uns8t3d/honda_accord7_serial_reader_and_subdisplay/img/schema.png

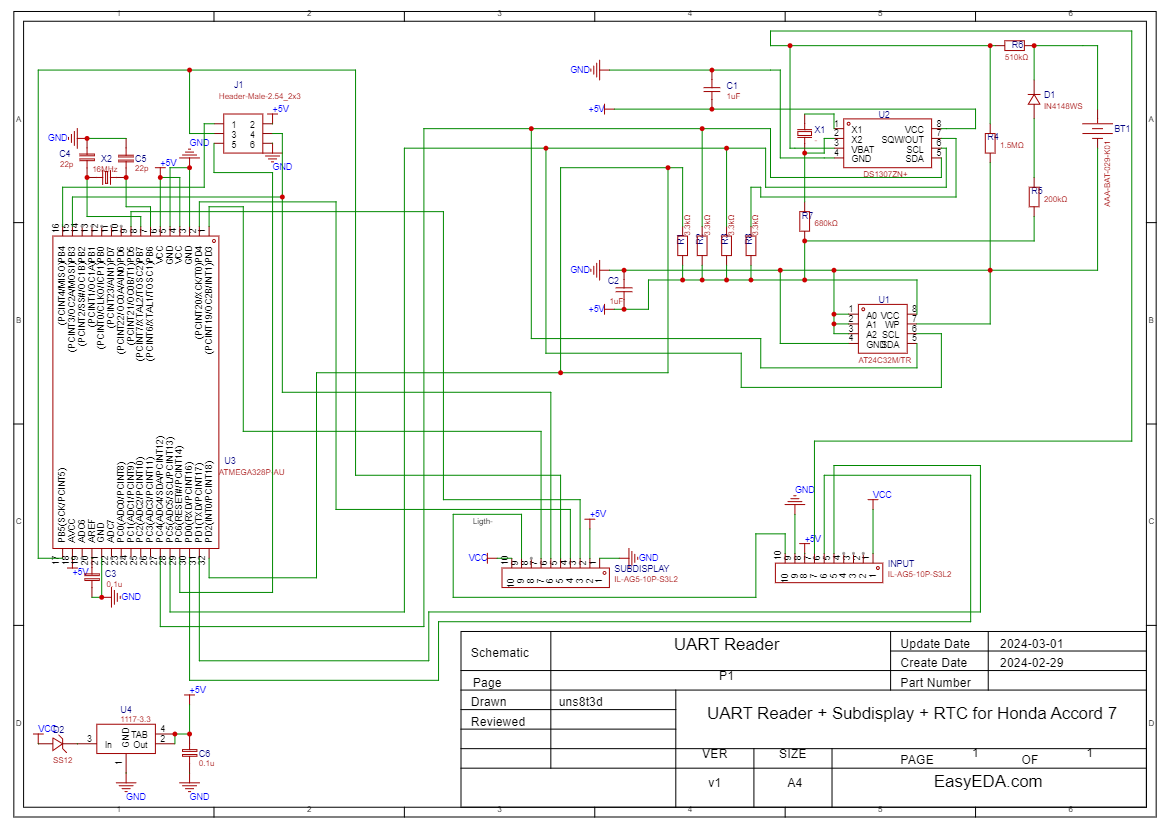
img/schema.png
