uns8t3d/honda_accord7_serial_reader_and_subdisplay/PCB/V2/V2_back.png

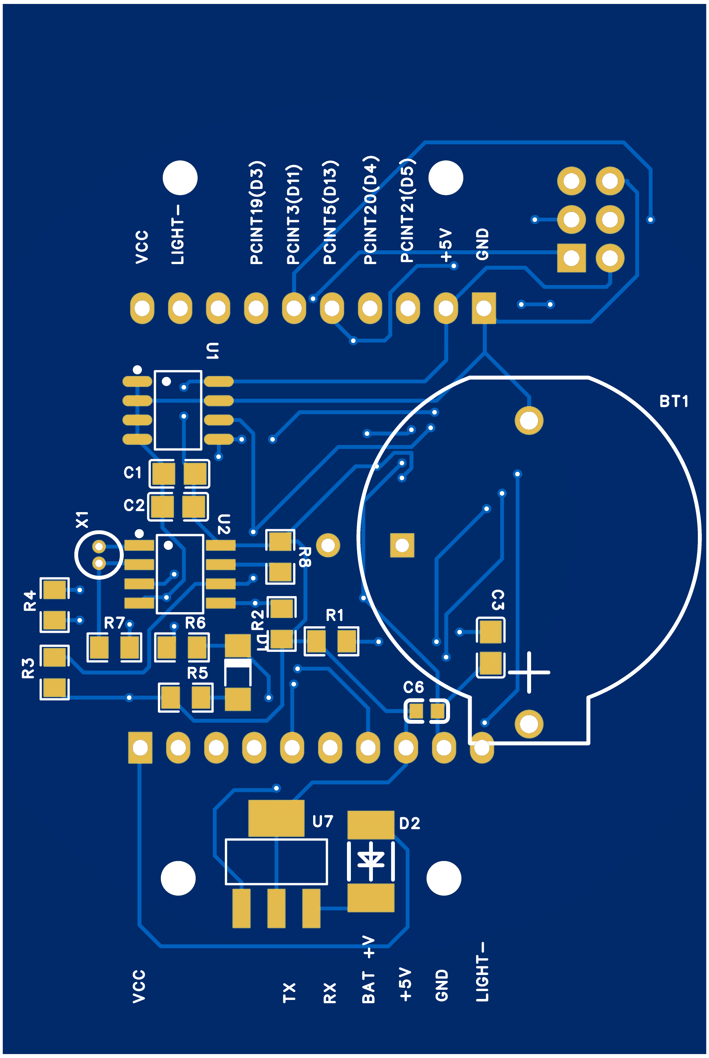
PCB/V2/V2_back.png
