uns8t3d/honda_accord7_serial_reader_and_subdisplay/PCB/V2/SerialReaderAndSubdisplay_V2_BOM.xlsx

No. | Quantity | Comment | Designator | Footprint | Value | Manufacturer Part | Manufacturer | Supplier Part | Supplier | Pins
1 | 1 | AAA-BAT-029-K01 | BT1 | BAT-TH_AAA-BAT-029-K01 |  | AAA-BAT-029-K01 | LOTES(嘉澤端子) | C962133 | LCSC | 2
2 | 2 | 1uF | C1,C2 | C0805 |  |  |  |  |  | 2
3 | 1 | 0.1u | C3 | C0805 |  |  |  |  |  | 2
4 | 2 | 22p | C4,C5 | C0603 |  |  |  |  |  | 2
5 | 1 | 0.1u | C6 | C0603 |  |  |  |  |  | 2
6 | 1 | IN4148WS | D1 | SOD-80_L3.5-W1.5-RD |  | IN4148WS | LRC(乐山无线电) | C417545 | LCSC | 2
7 | 1 | SS12 | D2 | SMA-L_L4.4-W2.6-LS5.0-RD |  | SS12 |  | C379819 | LCSC | 2
8 | 2 | IL-AG5-10P-S3L2 | INPUT,SUBDISPLAY | CONN-TH_10P-P2.50_IL-AG5-10P-S3L2 |  | IL-AG5-10P-S3L2 | JAE(日本航空电子) | C2891425 | LCSC | 10
9 | 1 | Header-Male-2.54_2x3 | J1 | HDR-TH_6P-P2.54-V-M-R2-C3-S2.54-1 |  | Header-Male-2.54_2x3 | BOOMELE | C65114 | LCSC | 6
10 | 4 | 3.3kΩ | R1,R2,R3,R8 | R0805 |  | ERA6VEB4702V | PANASONIC(松下) | C490805 | LCSC | 2
11 | 1 | 1.5MΩ | R4 | R0805 |  | ERA6VEB4702V | PANASONIC(松下) | C490805 | LCSC | 2
12 | 1 | 200kΩ | R5 | R0805 |  | ERA6VEB4702V | PANASONIC(松下) | C490805 | LCSC | 2
13 | 1 | 510kΩ | R6 | R0805 |  | ERA6VEB4702V | PANASONIC(松下) | C490805 | LCSC | 2
14 | 1 | 680kΩ | R7 | R0805 |  | ERA6VEB4702V | PANASONIC(松下) | C490805 | LCSC | 2
15 | 1 | AT24C32M/TR | U1 | SOP-8_L4.9-W3.9-P1.27-LS6.0-BL |  | AT24C32M/TR | HGSEMI(华冠) | C2688466 | LCSC | 8
16 | 1 | DS1307ZN+ | U2 | SOIC-8_L4.9-W4.0-P1.27-LS6.0-BL |  | DS1307ZN+ | ADI(亚德诺)/MAXIM(美信) | C3304433 | LCSC | 8
17 | 1 | ATMEGA328P-AU | U3 | TQFP-32_L7.0-W7.0-P0.80-LS9.0-BL |  | ATMEGA328P-AU | MICROCHIP | C14877 | LCSC | 32
18 | 1 | 1117-3.3 | U4 | SOT-223-3_L6.4-W3.5-P2.30-LS7.0-BR |  | 1117-3.3 | IDCHIP(英锐芯) | C5125088 | LCSC | 4
19 | 1 | - | X1 | OSC-TH_BD3.0-P1.10-D0.4 |  | DT-38 32.768KHz | KDS(大真空) | C93228 | LCSC | 2
20 | 1 | 16MHz | X2 | HC-49US_L11.5-W4.5-P4.88 |  | 49S-26.00-20-20-20/A | SuzhouLimingElec | C240942 | LCSC | 2
