uns8t3d/honda_accord7_serial_reader_and_subdisplay/img/schema.pdf

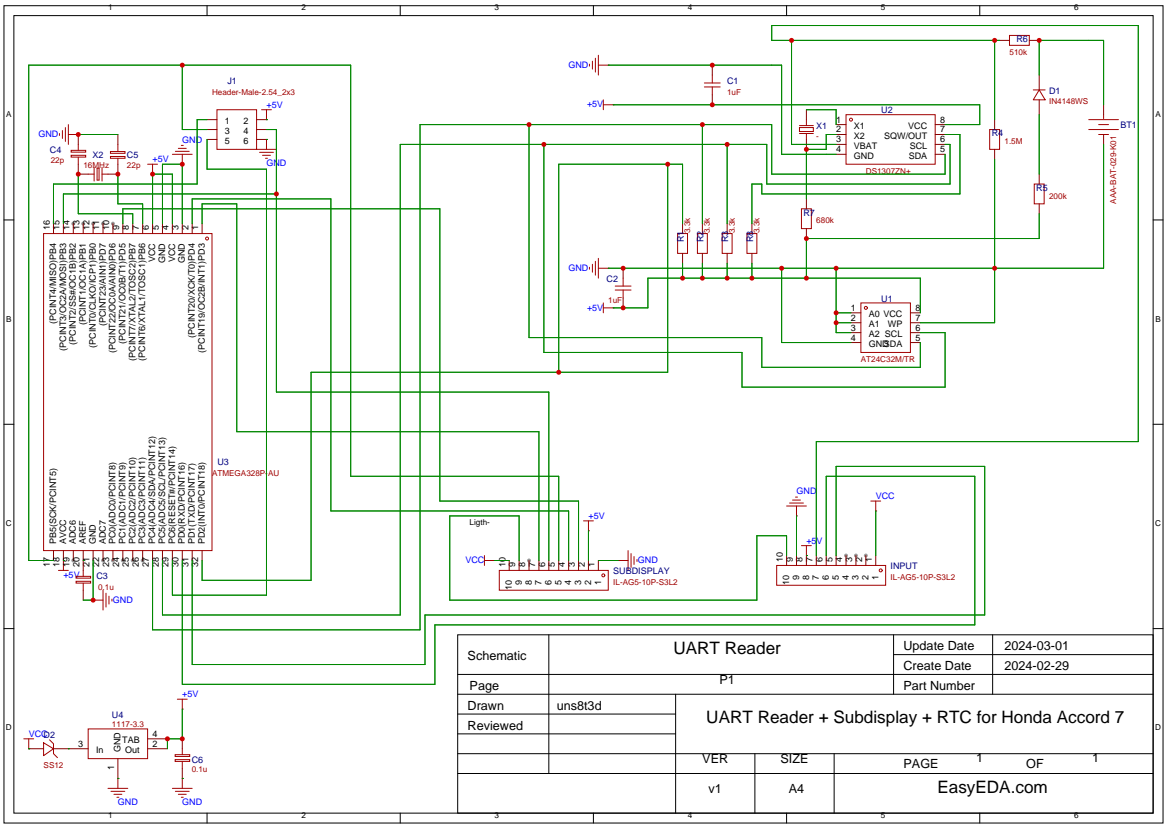
[picture p4: page 1]

9 (PCINT22/OC0A/AIN0)PD6 10 (PCINT23/AIN1)PD7 11 (PCINT0/CLKO/ICP1)PB0 12 (PCINT1/OC1A)PB1 13 (PCINT2/SS#/OC1B)PB2 14 (PCINT3/OC2A/MOSI)PB3 15 (PCINT4/MISO)PB4 16 PB5(SCK/PCINT5) 17 AVCC 18 ADC6 19 AREF 20 GND 21 ADC7 22 PC0(ADC0/PCINT8) 23 PC1(ADC1/PCINT9) 24

UART Reader + Subdisplay + RTC for Honda Accord 7
