uns8t3d/honda_accord7_serial_reader_and_subdisplay/src/navi_subdisplay.h

#ifndef navi_subdisplay_h
#define navi_subdisplay_h

#include <Arduino.h>
#include <avr/pgmspace.h>

#define LATCH_SIZE 7
#define DATA_SIZE 6
#define SLAVE_PIN 4

const byte asciiMap[95][4] = {
  { 0, 0, 0, 0 }, // SPACE - ASCII 32
  { 0, 0, 0, 0b01000000 }, // ! (mode 2)
  { 0, 0, 0, 0 }, // "
  { 0, 0, 0b10000000, 0b01000000 }, // # (mode 4)
  { 0, 0, 0b10000000, 0 }, // $ (mode 6)
  { 0, 0, 0b10110000, 0 }, // % (mode 8)
  // { 0b10000000, 0b10000000, 0, 0b00100000 }, // & (mode man)
  { 0, 0b01010000, 0b00010000, 0 }, // & (mode man)
  { 0, 0, 0, 0 }, // '
  { 0, 0, 0, 0 }, // (
  { 0, 0, 0, 0 }, // )
  { 0b00100000, 0b01100000, 0b01100000, 0b00100000 }, // *
  { 0, 0b10110000, 0b00100000, 0 }, // +
  { 0, 0, 0, 0 }, // ,
  { 0, 0b10010000, 0, 0 }, // -
  { 0b00100000, 0b01000000, 0b01000000, 0b00100000 }, // .
  { 0, 0b01000000, 0, 0b00100000 }, // /
  { 0b11010000, 0b01000000, 0b10010000, 0b01100000 }, // 0 - ASCII 48 0,
  { 0b00010000, 0, 0b00010000, 0 }, // 1
  { 0b11000000, 0b10010000, 0b00010000, 0b01000000 }, // 2
  { 0b01010000, 0b10010000, 0b00010000, 0b01000000 }, // 3
  { 0b00010000, 0b10010000, 0b10010000, 0 }, // 4
  { 0b01010000, 0b10010000, 0b10000000, 0b01000000 }, // 5
  { 0b11010000, 0b10010000, 0b10000000, 0b01000000 }, // 6
  { 0b00010000, 0, 0b00010000, 0b01000000 }, // 7
  { 0b11010000, 0b10010000, 0b10010000, 0b01000000}, // 8
  { 0b01010000, 0b10010000, 0b10010000, 0b01000000 }, // 9 - ASCII 57
  { 0, 0b00100000, 0b00100000, 0 }, // :
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
};

class NaviSubDisplay {
	public:
		NaviSubDisplay();
		void begin();
    void text(const char *pString);
    void render();
    void setClimatTemp(int8_t dTempIndex, int8_t pTempIndex);
    void clear();
    void clock(byte hours, byte minutes, boolean showPoints);
  private:
};

#endif
